Dfinitski/SDR-Micron/PCB/Manuals/AML30_Antenne.jpg

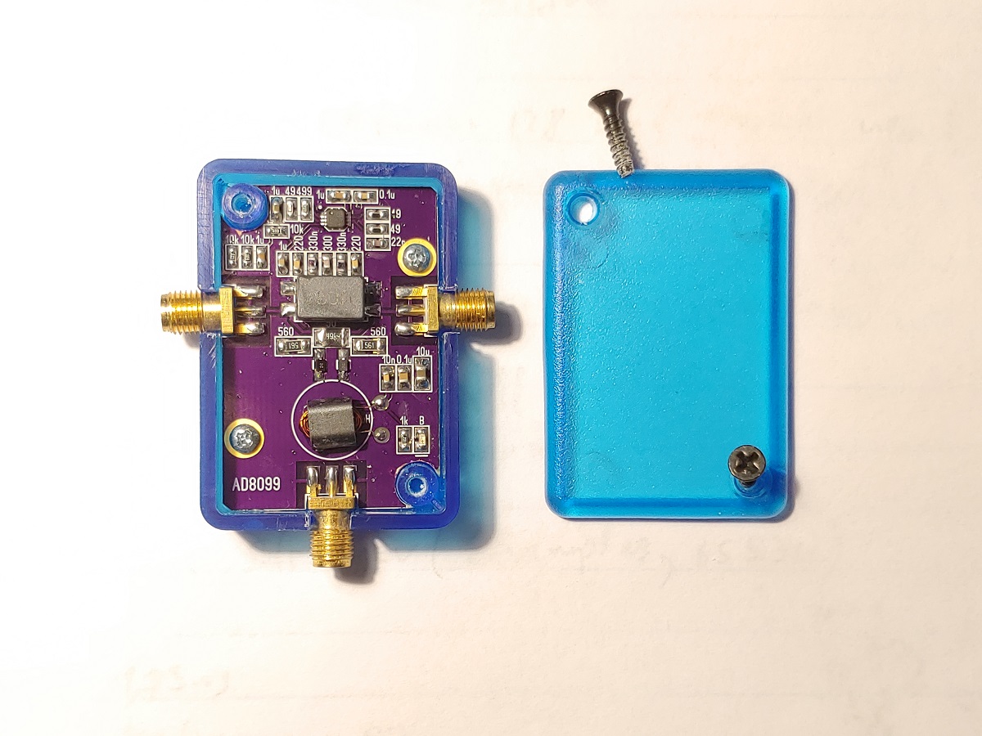
PCB/Manuals/AML30_Antenne.jpg
