Dfinitski/SDR-Micron/PCB/Manuals/BL_4.jpg

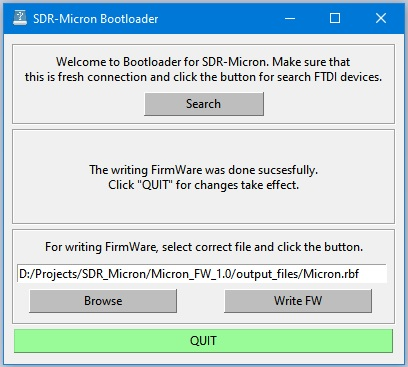
PCB/Manuals/BL_4.jpg
