Dfinitski/SDR-Micron/PCB/Manuals/AML-30_Schematic.JPG

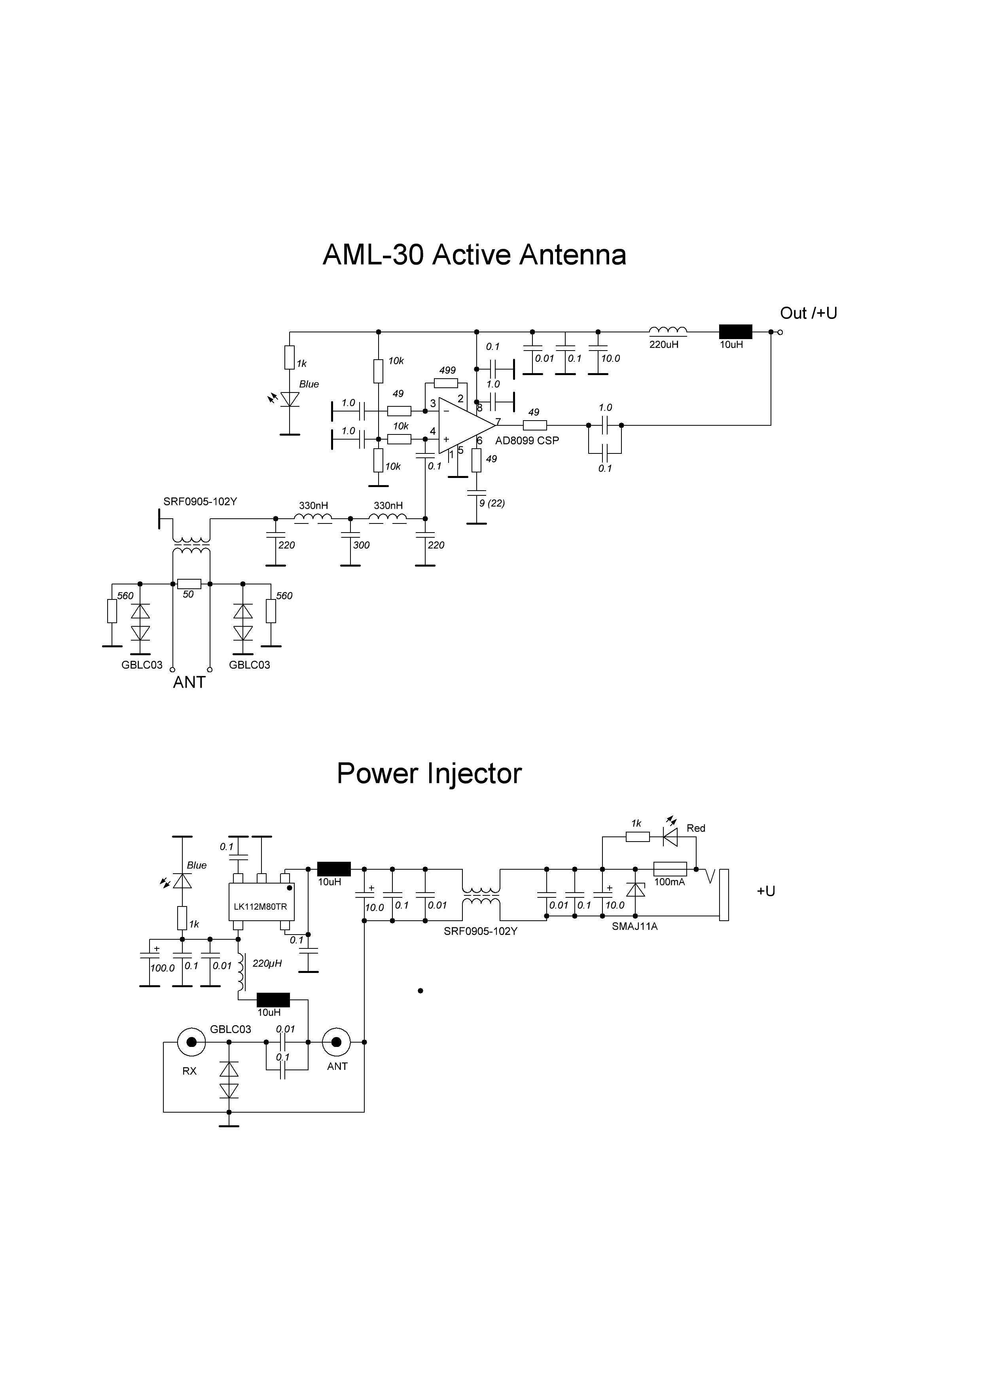
PCB/Manuals/AML-30_Schematic.JPG
