Dfinitski/SDR-Micron/PCB/Micron_AD_cart.xlsx

Index | Quantity | Part Number | Manufacturer Part Number | Description | Customer Reference | Available | Backorder | Unit Price | Extended Price USD
1 | 1 | HM969-ND | 1455C801 | BOX ALUM NATURAL 3.15"L X 2.13"W |  | 1 | 0 | 13.9 | 13.90
2 | 1 | ED3864-16-ND | 350-10-116-00-001000 | CONN HEADER VERT 16POS 2.54MM |  | 1 | 0 | 2.64 | 2.64
3 | 1 | ED7464-16-ND | 310-13-116-41-001000 | CONN RCPT 16POS 0.1 GOLD PCB |  | 1 | 0 | 2.54 | 2.54
4 | 1 | 800-2972-ND | F1912NCGI | RF ATTENUATOR 0.5DB 50OHM 20QFN |  | 1 | 0 | 5.88 | 5.88
5 | 1 | MCP1700T-2502E/TTCT-ND | MCP1700T-2502E/TT | IC REG LINEAR 2.5V 250MA SOT23-3 |  | 1 | 0 | 0.38 | 0.38
6 | 1 | MCP1700T1802ETTCT-ND | MCP1700T-1802E/TT | IC REG LINEAR 1.8V 200MA SOT23-3 |  | 1 | 0 | 0.38 | 0.38
7 | 1 | 1265-1325-1-ND | AT25PE40-SSHN-T | IC IND TEMP 1.65V 8SOIC |  | 1 | 0 | 1.31 | 1.31
8 | 1 | SRF0905-501YCT-ND | SRF0905-501Y | CMC 500UH 1A 2LN 1 KOHM SMD |  | 1 | 0 | 1.45 | 1.45
9 | 1 | ED2983-ND | USB-B1HSB6 | CONN RCPT TYPEB 4POS R/A |  | 1 | 0 | 0.58 | 0.58
10 | 1 | 497-5235-1-ND | USBLC6-2SC6 | TVS DIODE 5.25V 17V SOT23-6 |  | 1 | 0 | 0.47 | 0.47
11 | 1 | 1465-1318-1-ND | MABAES0061 | BALUN 2MHZ-800MHZ 1:4 6SMD FLAT |  | 1 | 0 | 2.11 | 2.11
12 | 1 | 544-3578-ND | 10CL010YE144C8G | IC FPGA 88 I/O 144EQFP |  | 1 | 0 | 9.77 | 9.77
13 | 1 | MCP1826S-1202E/DB-ND | MCP1826S-1202E/DB | IC REG LINEAR 1.2V 1A SOT223-3 |  | 1 | 0 | 0.7 | 0.70
14 | 1 | MCP1826S-3302E/DB-ND | MCP1826S-3302E/DB | IC REG LINEAR 3.3V 1A SOT223-3 |  | 1 | 0 | 0.7 | 0.70
15 | 1 | MCP1824T-3302E/OTCT-ND | MCP1824T-3302E/OT | IC REG LINEAR 3.3V 300MA SOT23-5 |  | 1 | 0 | 0.43 | 0.43
16 | 1 | MCP1824T-1802E/OTCT-ND | MCP1824T-1802E/OT | IC REG LINEAR 1.8V 300MA SOT23-5 |  | 1 | 0 | 0.43 | 0.43
17 | 1 | AD8099ACPZ-REEL7CT-ND | AD8099ACPZ-REEL7 | IC OPAMP VFB 1 CIRCUIT 8LFCSP |  | 1 | 0 | 5.51 | 5.51
18 | 1 | 768-1102-1-ND | FT232HQ-REEL | IC HS USB TO UART/FIFO 48QFN |  | 1 | 0 | 4.25 | 4.25
19 | 1 | 93LC56BT-I/OTCT-ND | 93LC56BT-I/OT | IC EEPROM 2K SPI 2MHZ SOT23-6 |  | 1 | 0 | 0.22 | 0.22
20 | 1 | XC2882CT-ND | ECS-3225MV-120-CN-TR | XTAL OSC XO 12.0000MHZ HCMOS SMD |  | 1 | 0 | 0.97 | 0.97
21 | 1 | 800-3404-ND | 5P49V5923B000NLGI | IC CLOCK GENERATOR 24VFQFPN |  | 1 | 0 | 2.65 | 2.65
22 | 1 | 631-1067-1-ND | FT5HNBPK10.0-T1 | XTAL OSC TCXO 10.0000MHZ HCMOS |  | 1 | 0 | 2.36 | 2.36
23 | 1 | 507-1806-1-ND | 0ZCJ0100FF2E | PTC RESET FUSE 6V 1A 1206 |  | 1 | 0 | 0.21 | 0.21
24 | 4 | 535-10484-1-ND | AISC-0603-R33J-T | FIXED IND 330NH 100MA 4.2 OHM |  | 4 | 0 | 0.33 | 1.32
25 | 1 | AD9649BCPZ-80-ND | AD9649BCPZ-80 | IC ADC 14BIT PIPELINED 32LFCSP |  | 1 | 0 | 47.17 | 47.17
26 | 10 | 490-1015-1-ND | BLM18AG102SN1D | FERRITE BEAD 1 KOHM 0603 1LN |  | 10 | 0 | 0.079 | 0.79
27 | 1 | A97593-ND | 5-1814400-1 | CONN SMA JACK R/A 50 OHM PCB |  | 1 | 0 | 2.61 | 2.61
