Dfinitski/SDR-Micron/PCB/Manuals/AML30_2.jpg

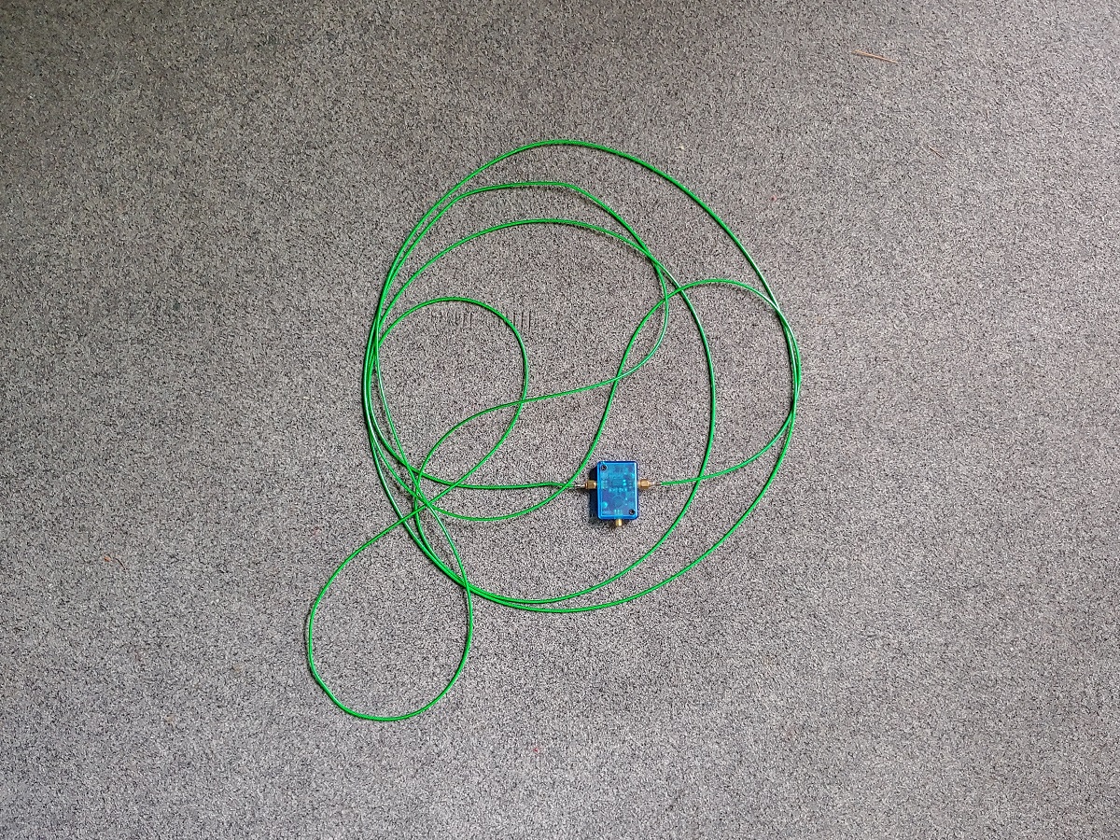
PCB/Manuals/AML30_2.jpg
