Dfinitski/SDR-Micron/PCB/Manuals/aml30_graf.png

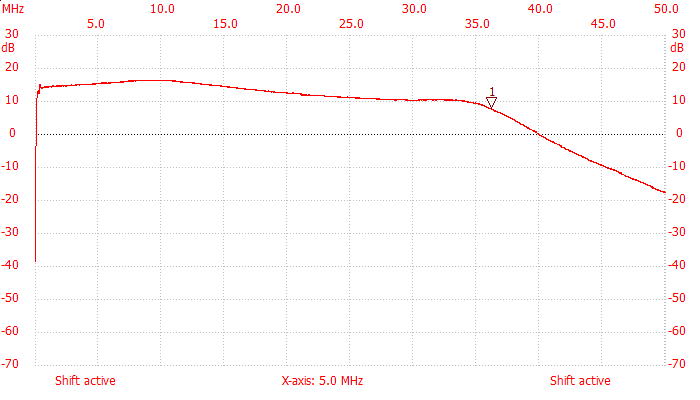
PCB/Manuals/aml30_graf.png
