Dfinitski/SDR-Micron/PCB/Manuals/AML30_Injector.jpg

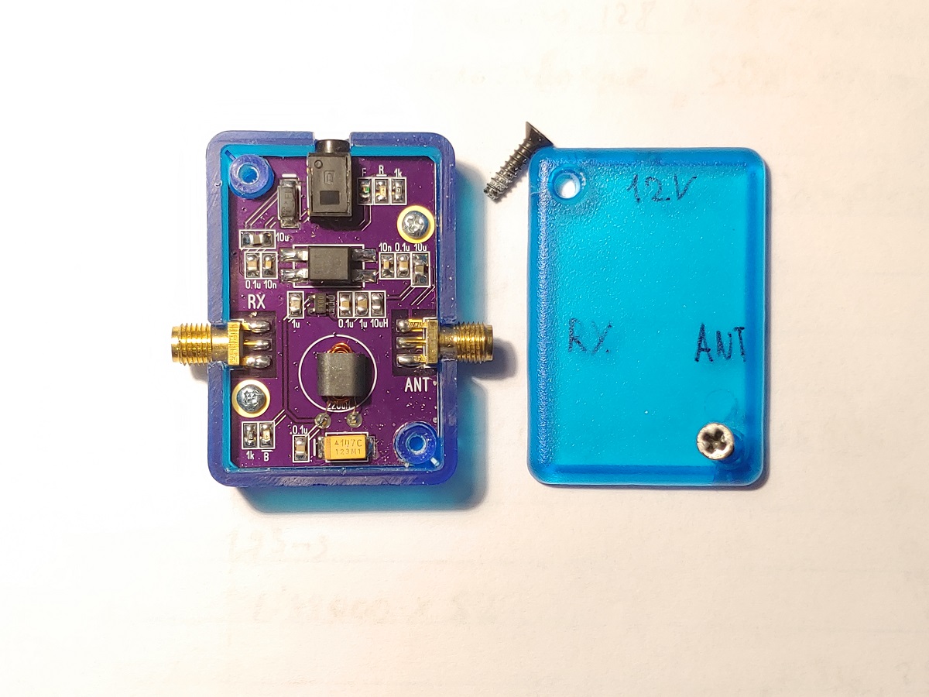
PCB/Manuals/AML30_Injector.jpg
