Dfinitski/SDR-Micron/PCB/Manuals/aml30_rej.png

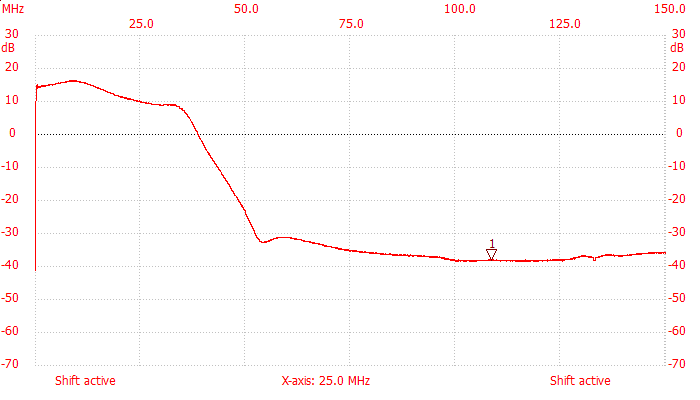
PCB/Manuals/aml30_rej.png
