Dfinitski/SDR-Micron/PCB/Manuals/dongle.jpg

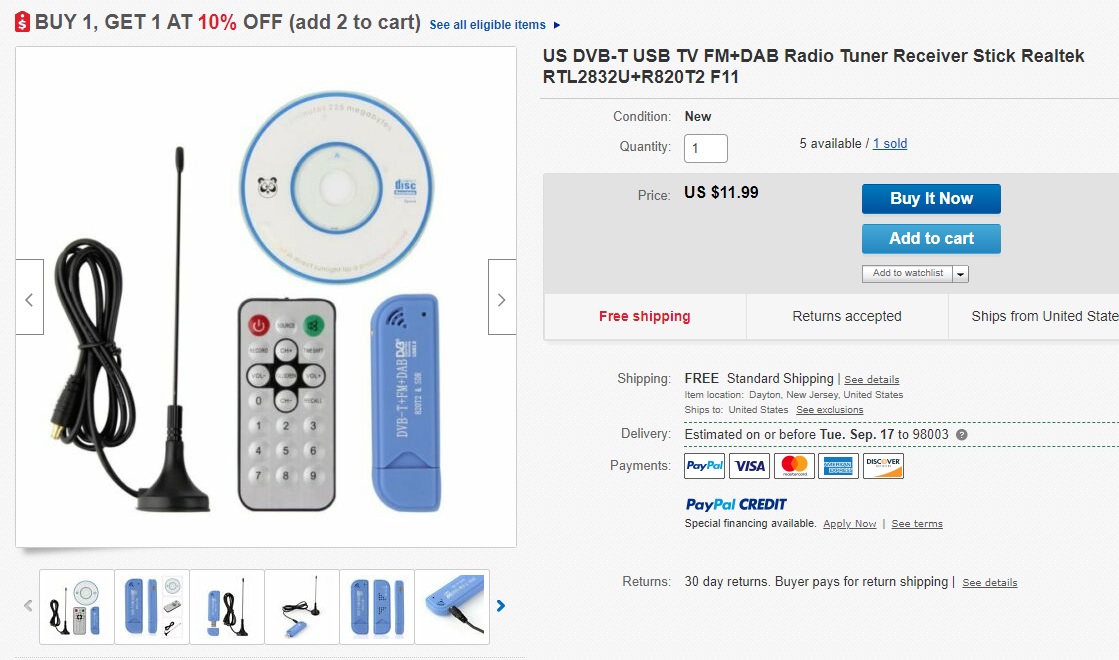
PCB/Manuals/dongle.jpg
