Dfinitski/SDR-Micron/PCB/Manuals/hub.jpg

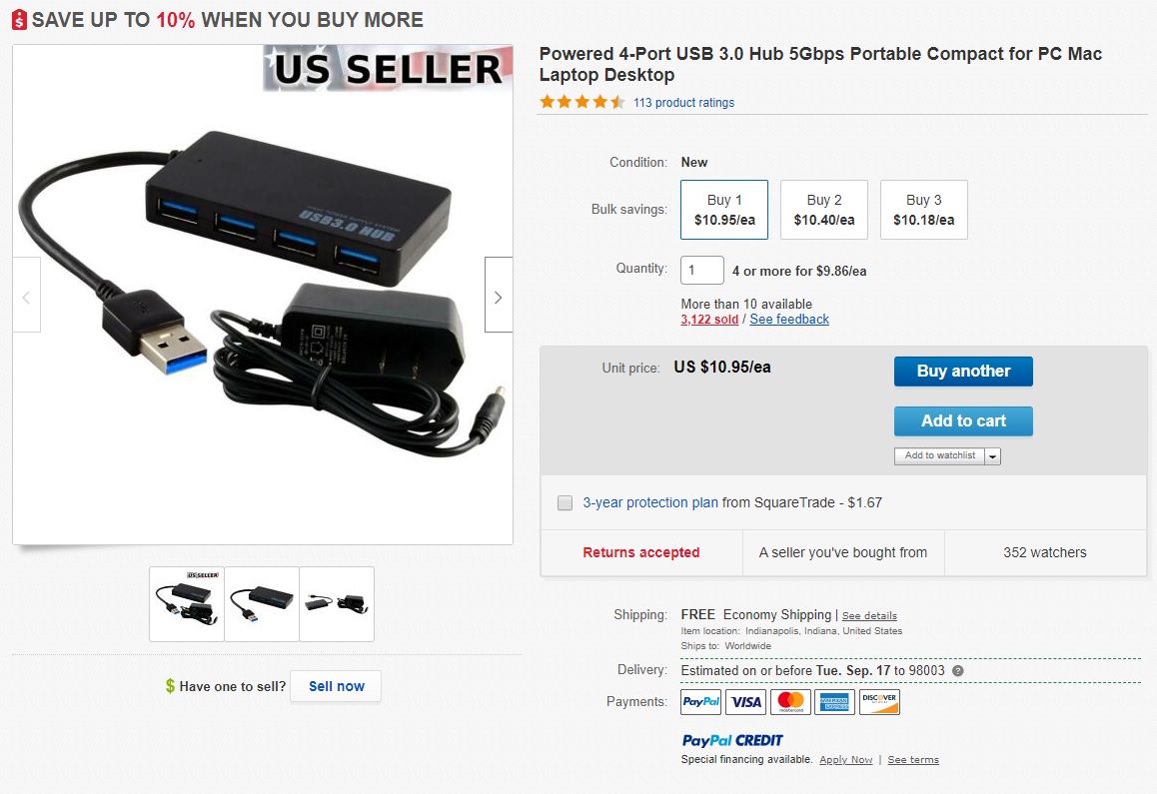
PCB/Manuals/hub.jpg
