Dfinitski/SDR-Micron/PCB/Manuals/Micron-R820.jpg

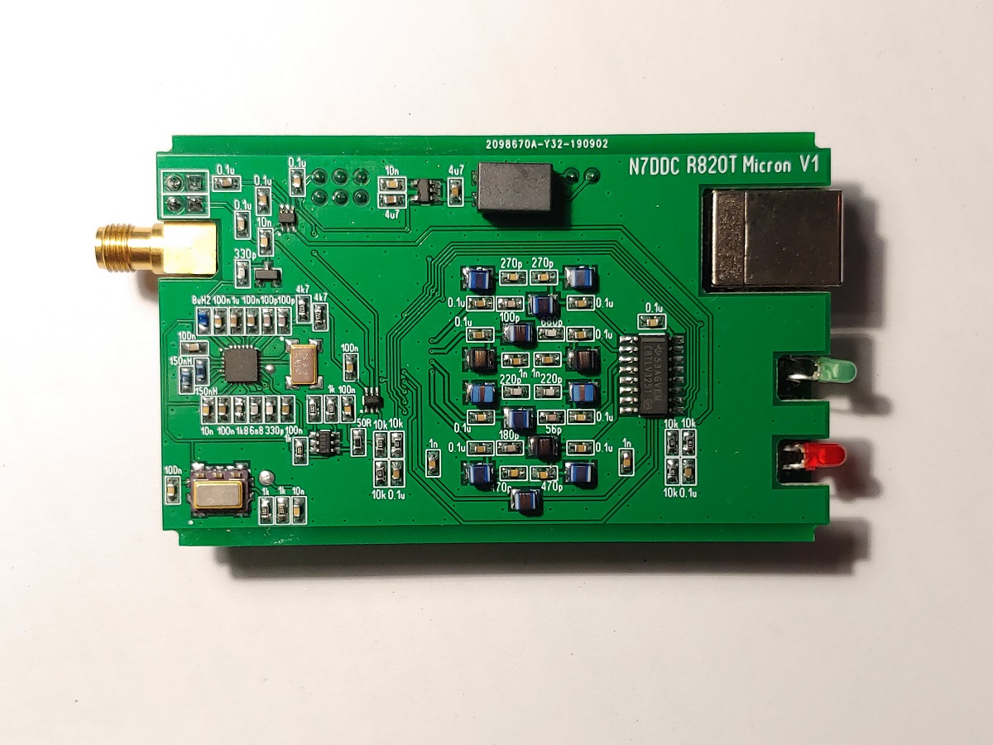
PCB/Manuals/Micron-R820.jpg
