Dfinitski/SDR-Micron/PCB/Manuals/micron_1.jpg

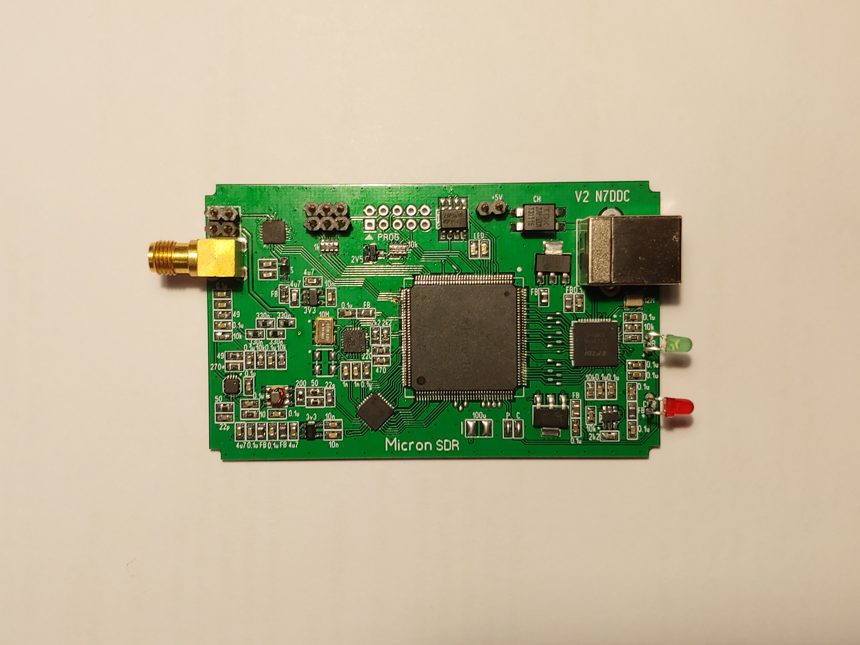
PCB/Manuals/micron_1.jpg
