Dfinitski/SDR-Micron/PCB/Manuals/micron_2.jpg

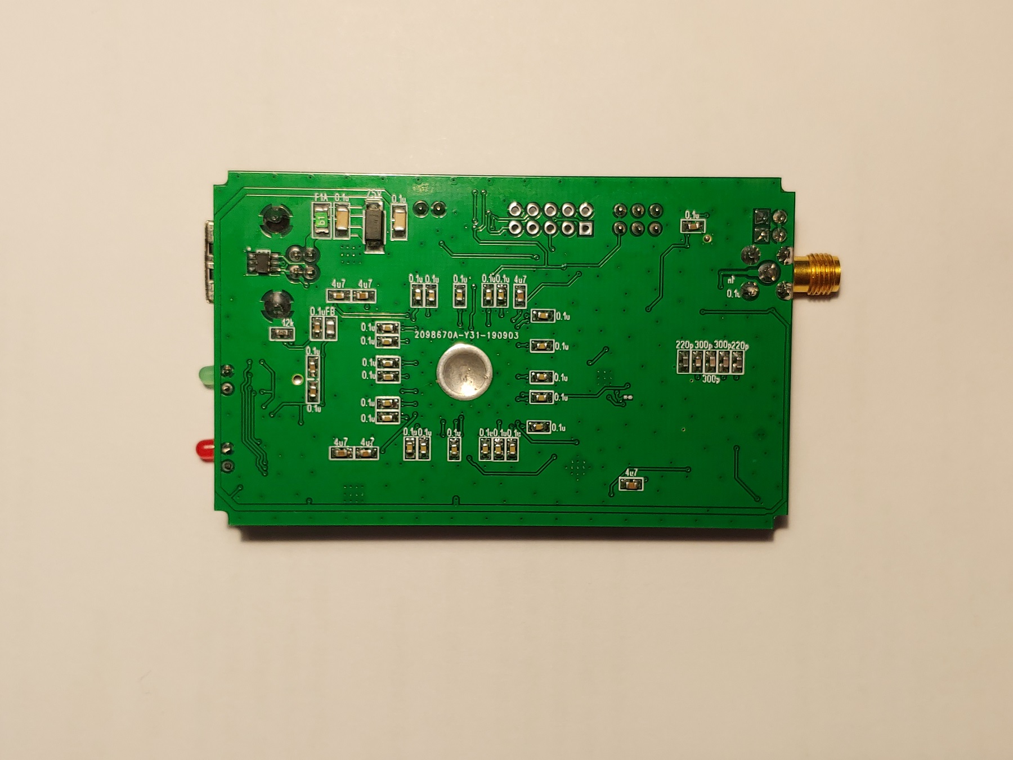
PCB/Manuals/micron_2.jpg
