Dfinitski/SDR-Micron/PCB/Manuals/Micron_-13.5_100kHz.jpg

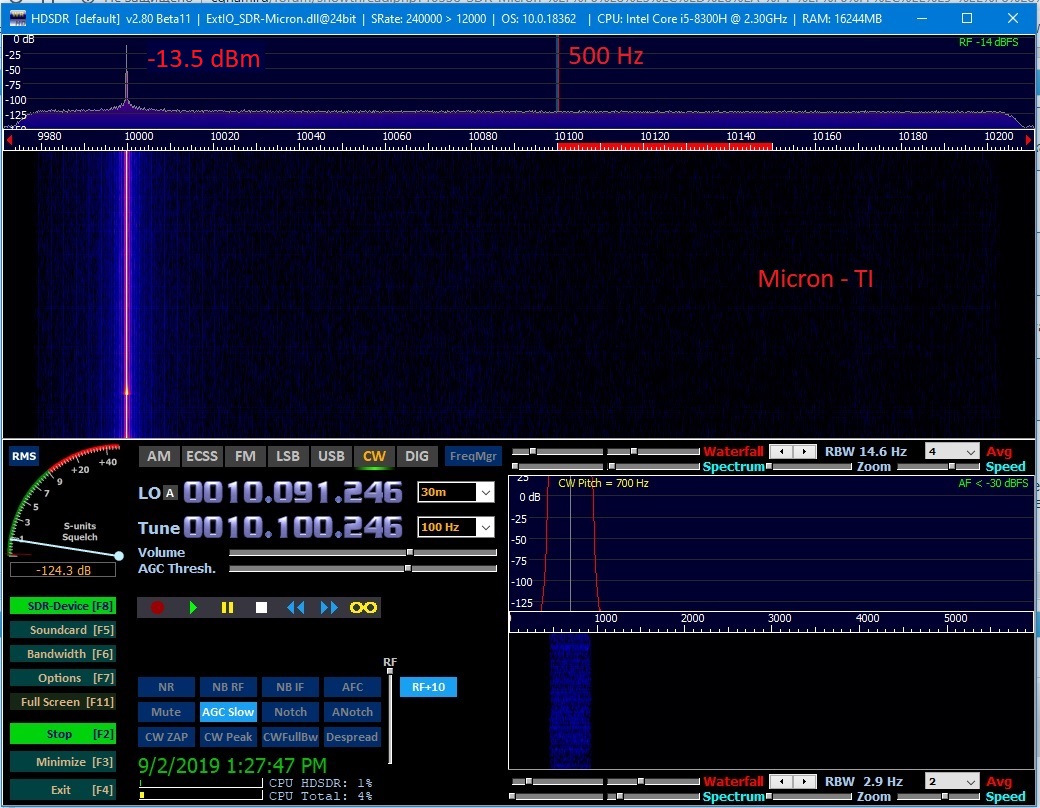
PCB/Manuals/Micron_-13.5_100kHz.jpg
