Dfinitski/SDR-Micron/PCB/Manuals/Micron_-33.5_10kHz.jpg

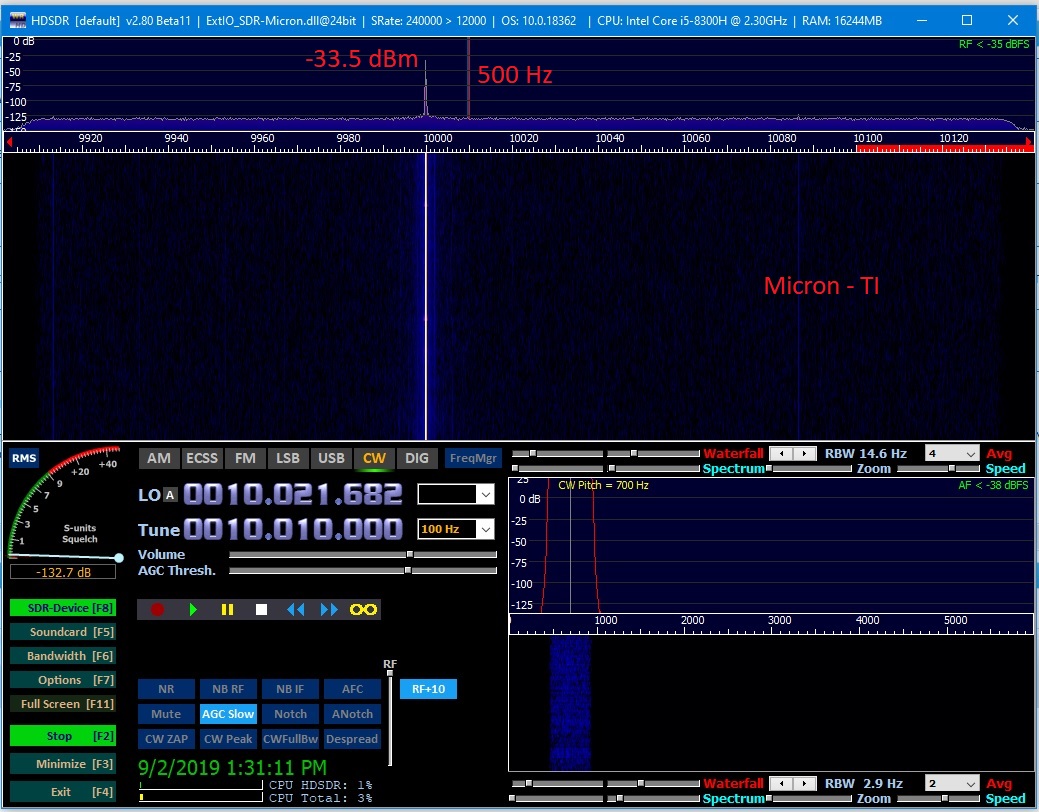
PCB/Manuals/Micron_-33.5_10kHz.jpg
