Dfinitski/SDR-Micron/PCB/Manuals/Micron_MDS.jpg

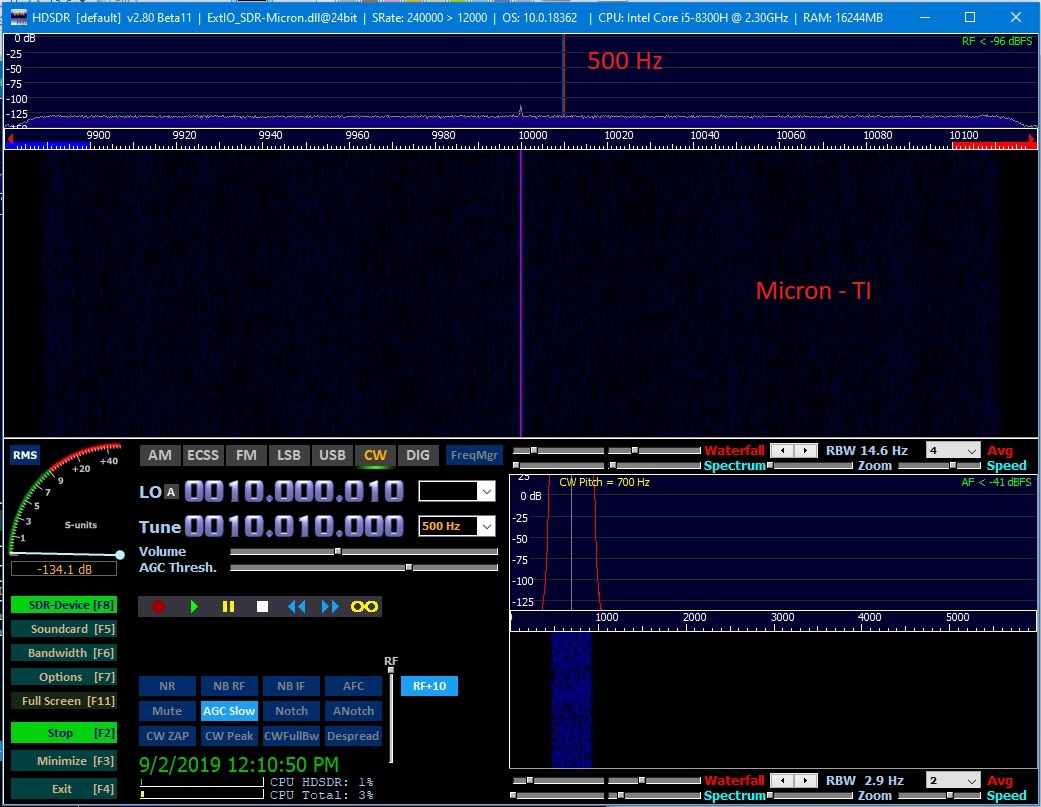
PCB/Manuals/Micron_MDS.jpg
