Dfinitski/SDR-Micron/PCB/Manuals/Micron_RMDR.jpg

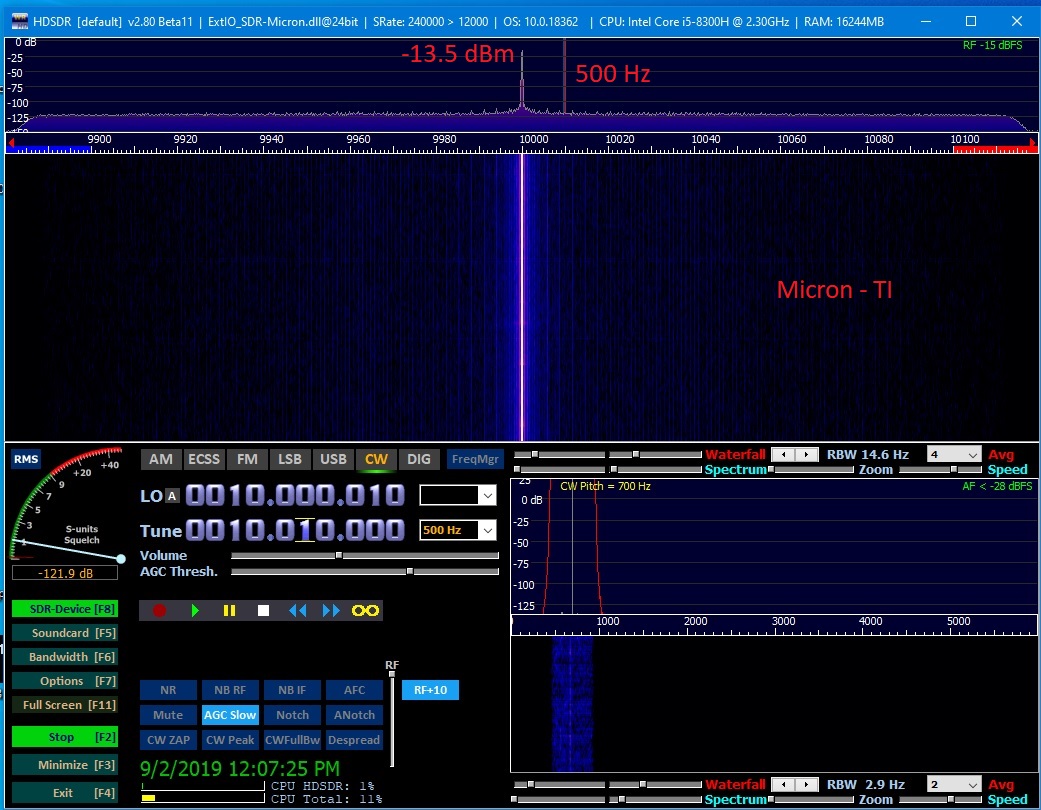
PCB/Manuals/Micron_RMDR.jpg
