Dfinitski/SDR-Micron/(list of files, drawings)

Other design files:
PCB/Manuals/AML-30_Schematic.spl7
PCB/SDR_MIcron-AD_Board.lay6
PCB/SDR_MIcron-TI_Board.lay6
PCB/SDR_MIcron_BPF.lay6
