Dfinitski/SDR-Micron/EXTIO/ExtIO_SDR-Micron/resource.h

//{{NO_DEPENDENCIES}}
// Microsoft Visual C++ generated include file.
// Used by ExtIO_SDR-Micron.rc
//
#define IDC_SAMPLE_RATE_COMBO           1000
#define IDC_ATTENUATION_COMBO           1001
#define IDB_LOGOBITMAP                  1002
#define IDC_VERSION                     1003
#define IDD_GUI                         1007

// Next default values for new objects
// 
#ifdef APSTUDIO_INVOKED
#ifndef APSTUDIO_READONLY_SYMBOLS
#define _APS_NEXT_RESOURCE_VALUE        1005
#define _APS_NEXT_COMMAND_VALUE         32771
#define _APS_NEXT_CONTROL_VALUE         1004
#define _APS_NEXT_SYMED_VALUE           1008
#endif
#endif
