Dfinitski/SDR-Micron/FirmWare_Verilog/Micron_FW_1.5_AD/m_reset.v

module master_reset (
	input clock,
	input pll,
	output reset		
	);
	
	reg [31:0] reset_timer;
   
	initial
	begin
		reset_timer = 32'd100_000;	// time to release reset = 0.5 sec
	end
	
	assign reset = (reset_timer == 0) & pll;
		
	always @(posedge clock)
		if (reset_timer != 0 & pll)
			reset_timer <= reset_timer - 1'd1;
			
endmodule
